dss-loris/main/Main.pdf

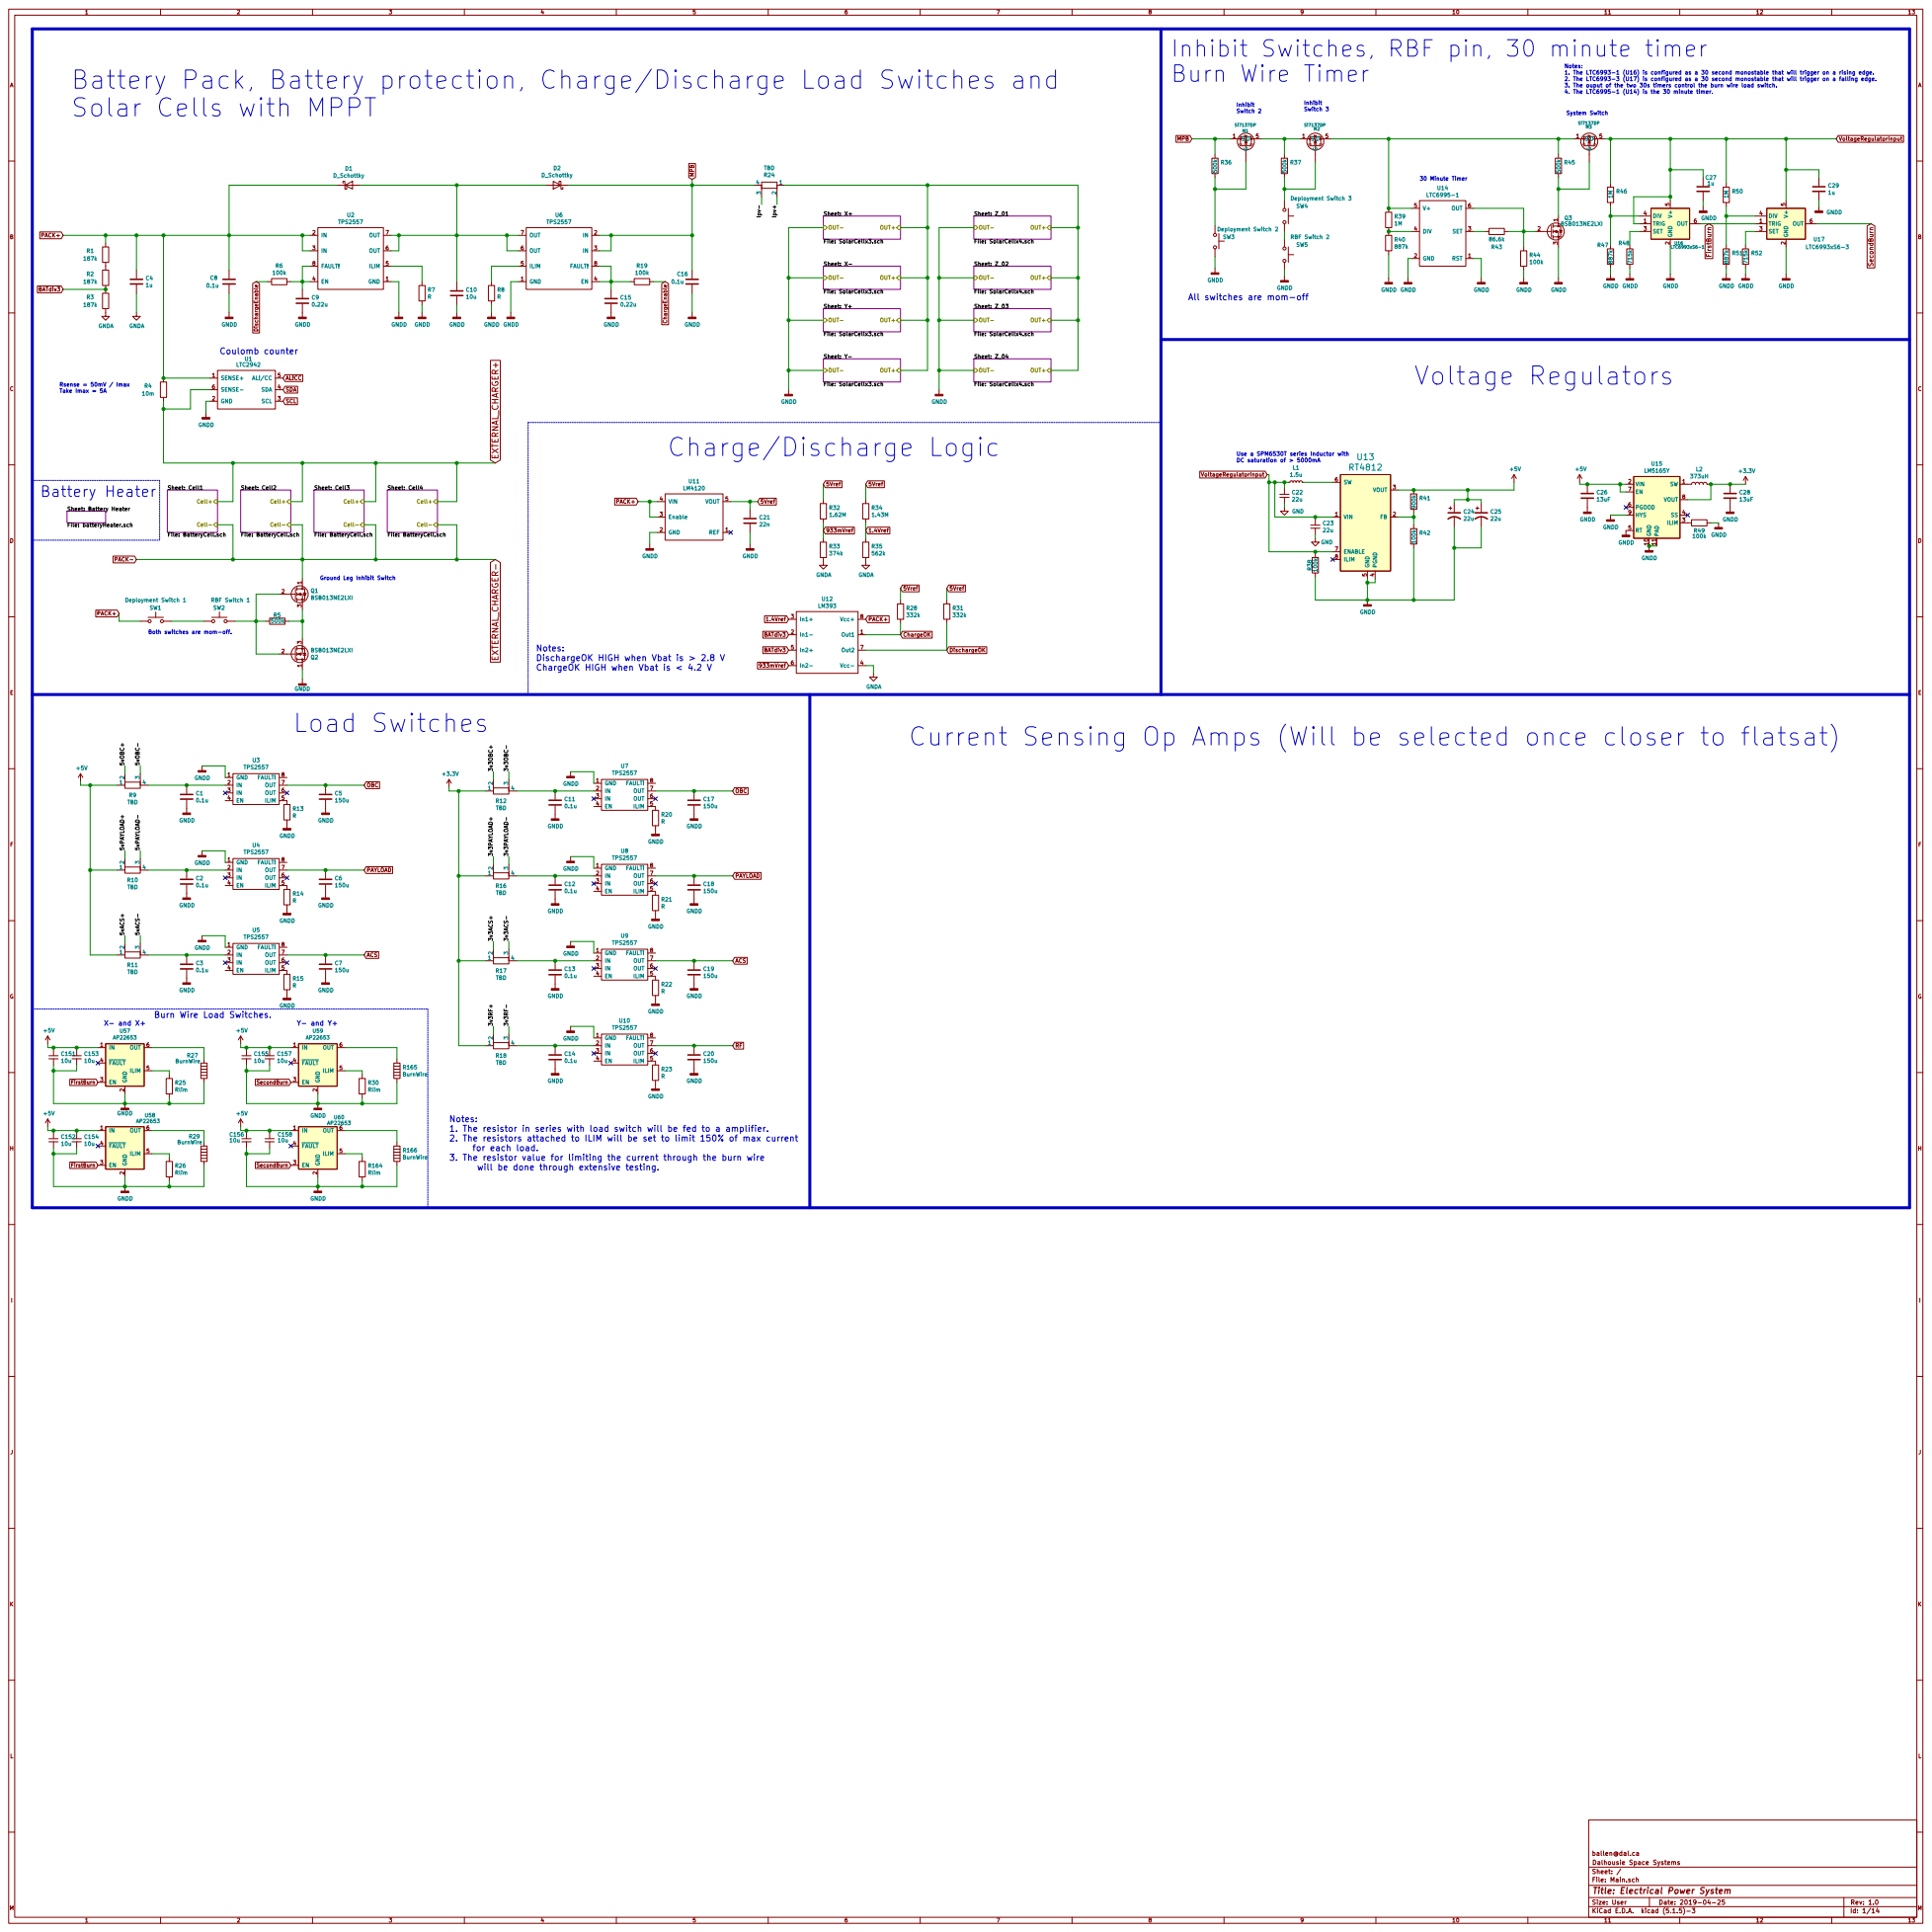
[picture p1: page 1]

Inhibit Switches, RBF pin, 30 minute timer
Burn Wire Timer

Solar Cells with MPPT

Notes: 1. The LTC6993-1 (U16) is configured as a 30 second monostable that will trigger on a rising edge.

2. The LTC6993-3 (U17) is configured as a 30 second monostable that will trigger on a falling edge.

Both switches are mom-off. Coulomb counter

GNDD
All switches are mom-off

Rsense = 50mV / Imax Take Imax = 5A

Notes:
DischargeOK HIGH when Vbat is > 2.8 V
ChargeOK HIGH when Vbat is < 4.2 V

Current Sensing Op Amps (Will be selected once closer to flatsat)

Burn Wire Load Switches.

1. The resistor in series with load switch will be fed to a amplifier.
2. The resistors attached to ILIM will be set to limit 150% of max current
for each load.
3. The resistor value for limiting the current through the burn wire
will be done through extensive testing.

ballen@dal.ca
File: Main.sch Sheet: / Dalhousie Space Systems

Id: 1/14 Title: Electrical Power System

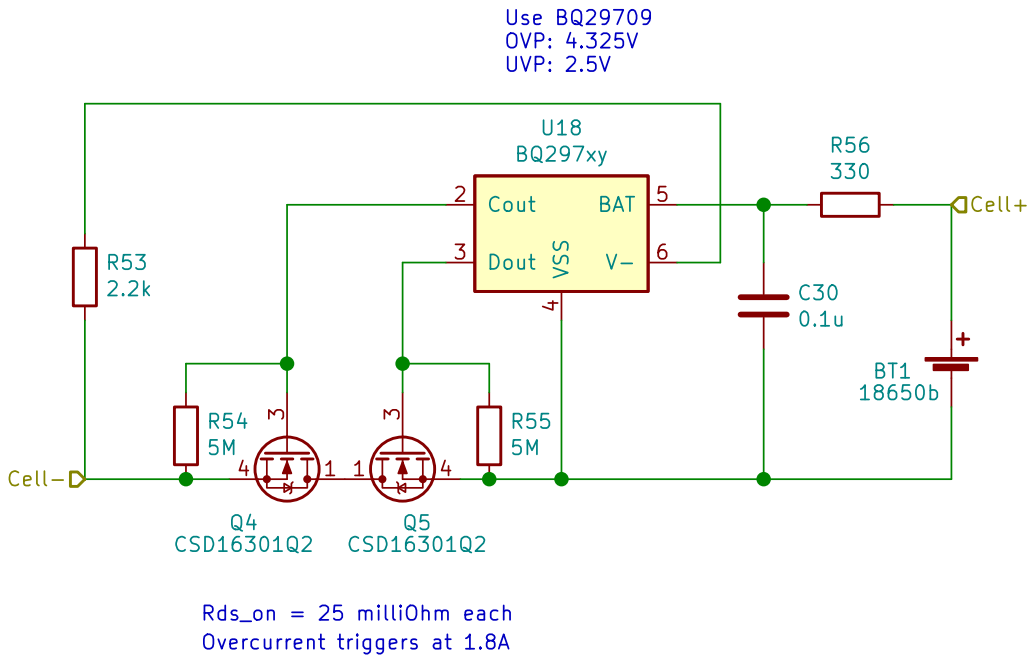
[picture p2: page 2]

File: BatteryCell.sch Sheet: /Cell1/
Id: 2/14 Title:

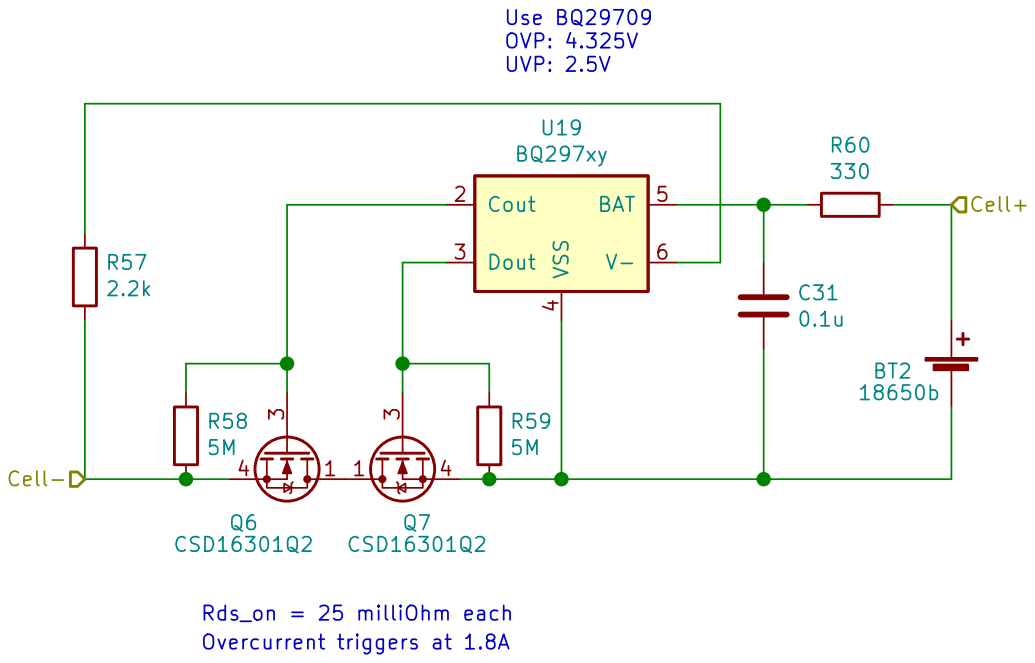
[picture p3: page 3]

File: BatteryCell.sch Sheet: /Cell2/
Id: 3/14 Title:

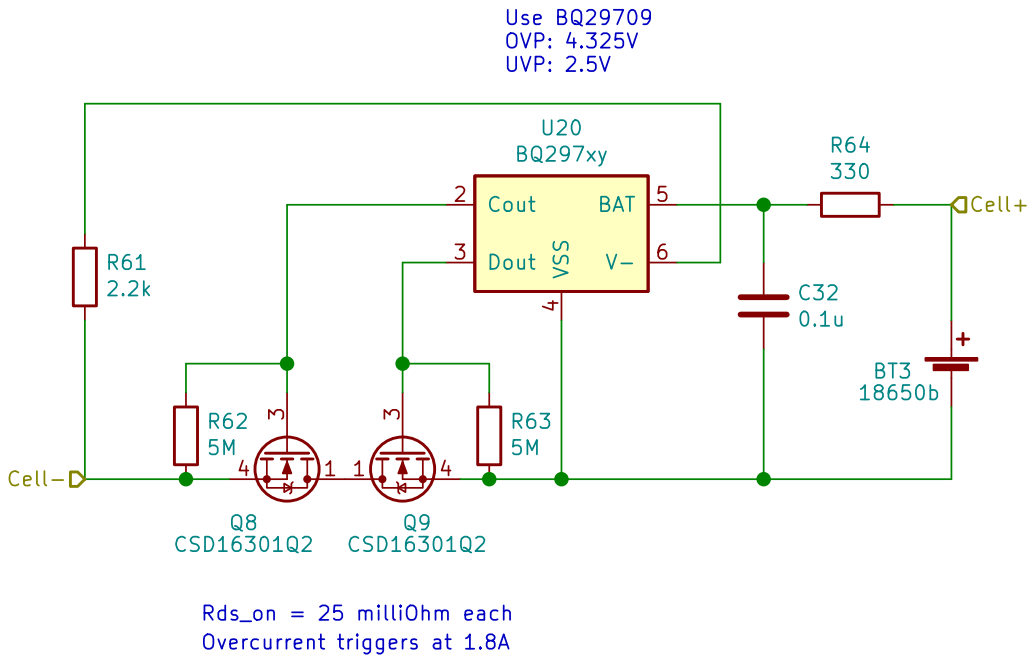
[picture p4: page 4]

File: BatteryCell.sch Sheet: /Cell3/
Id: 4/14 Title:

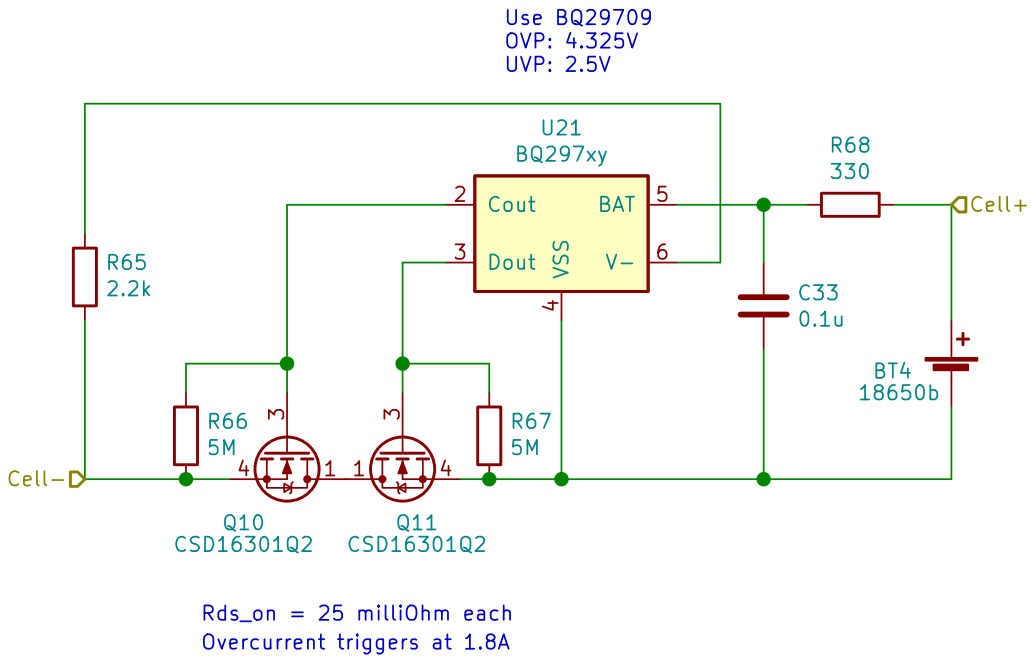
[picture p5: page 5]

File: BatteryCell.sch Sheet: /Cell4/
Id: 5/14 Title:

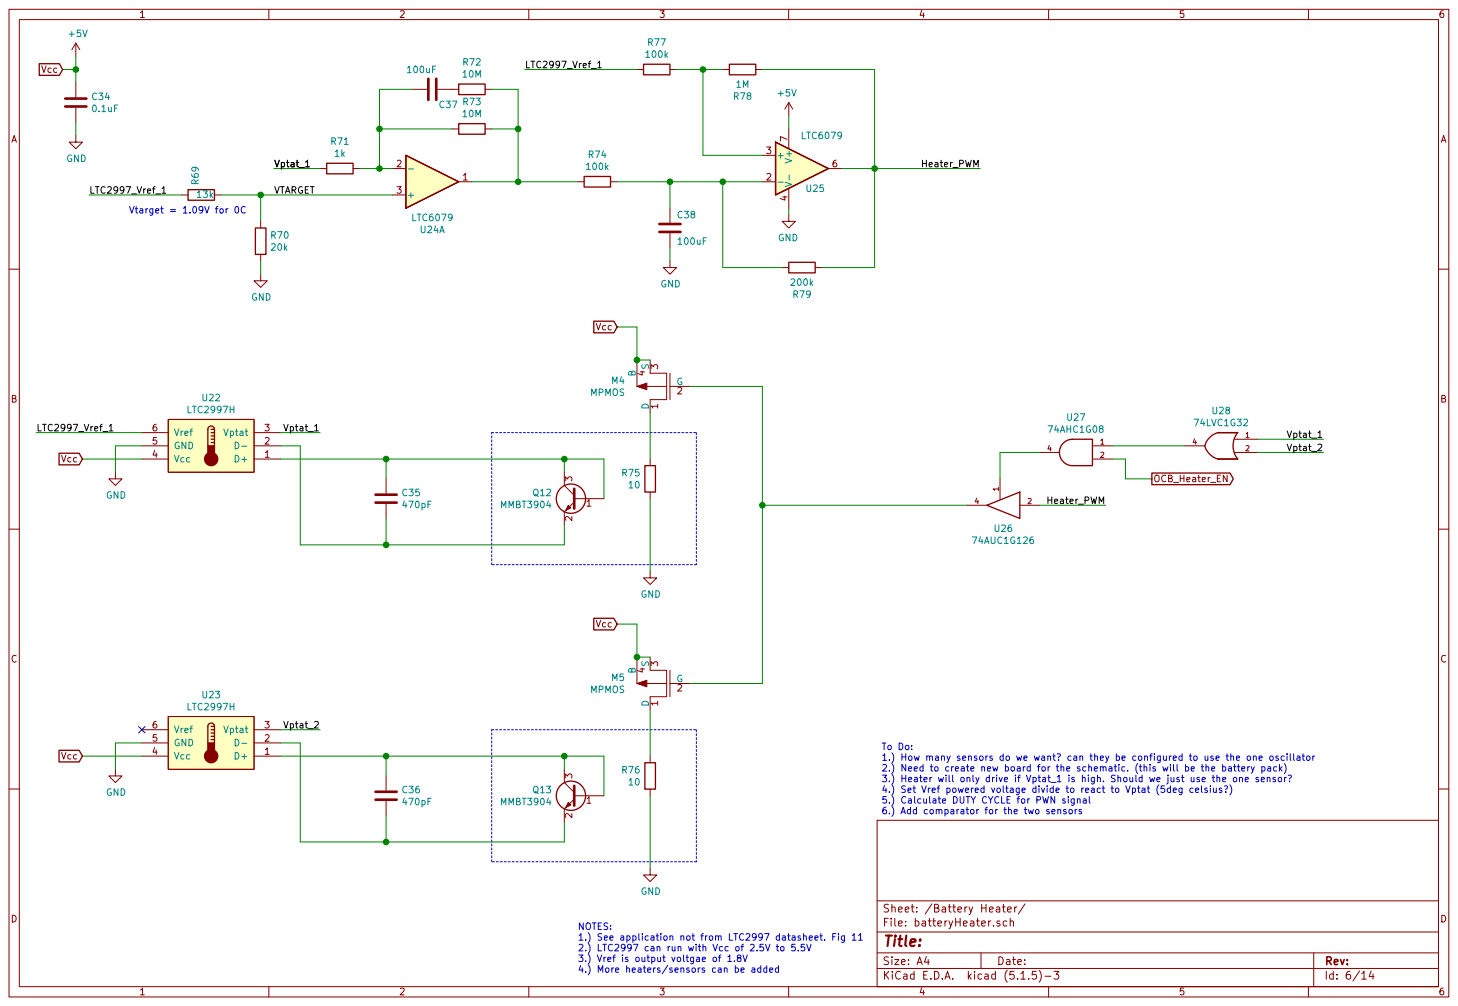
[picture p6: page 6]

Vptat_1 NOTES: 1.) See application not from LTC2997 datasheet. Fig 11

To Do: 1.) How many sensors do we want? can they be configured to use the one oscillator

2.) Need to create new board for the schematic. (this will be the battery pack)
3.) Heater will only drive if Vptat_1 is high. Should we just use the one sensor?
4.) Set Vref powered voltage divide to react to Vptat (5deg celsius?)
5.) Calculate DUTY CYCLE for PWN signal
6.) Add comparator for the two sensors

2.) LTC2997 can run with Vcc of 2.5V to 5.5V
3.) Vref is output voltgae of 1.8V
4.) More heaters/sensors can be added

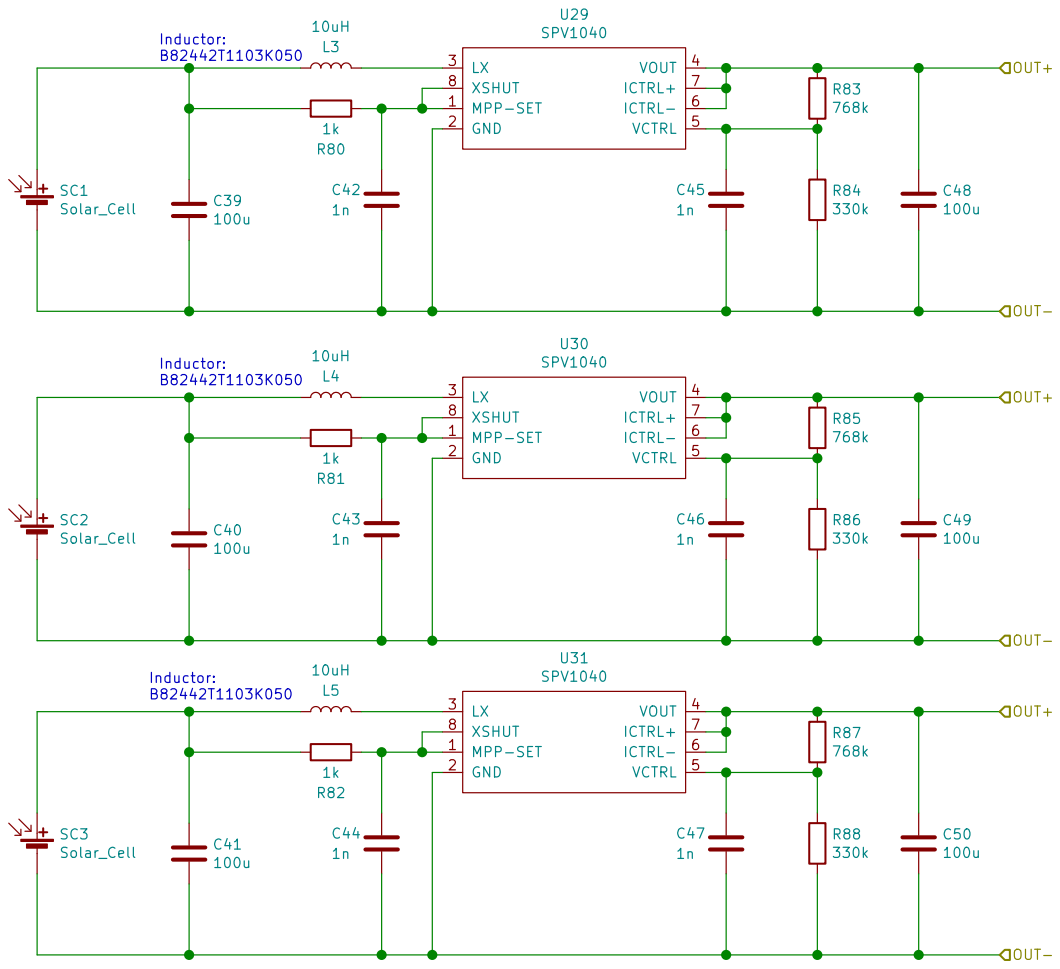
[picture p7: page 7]

OUT+ OUT+ OUT- OUT+ OUT-

Id: 7/14 Title: File: SolarCellx3.sch Sheet: /Y-/

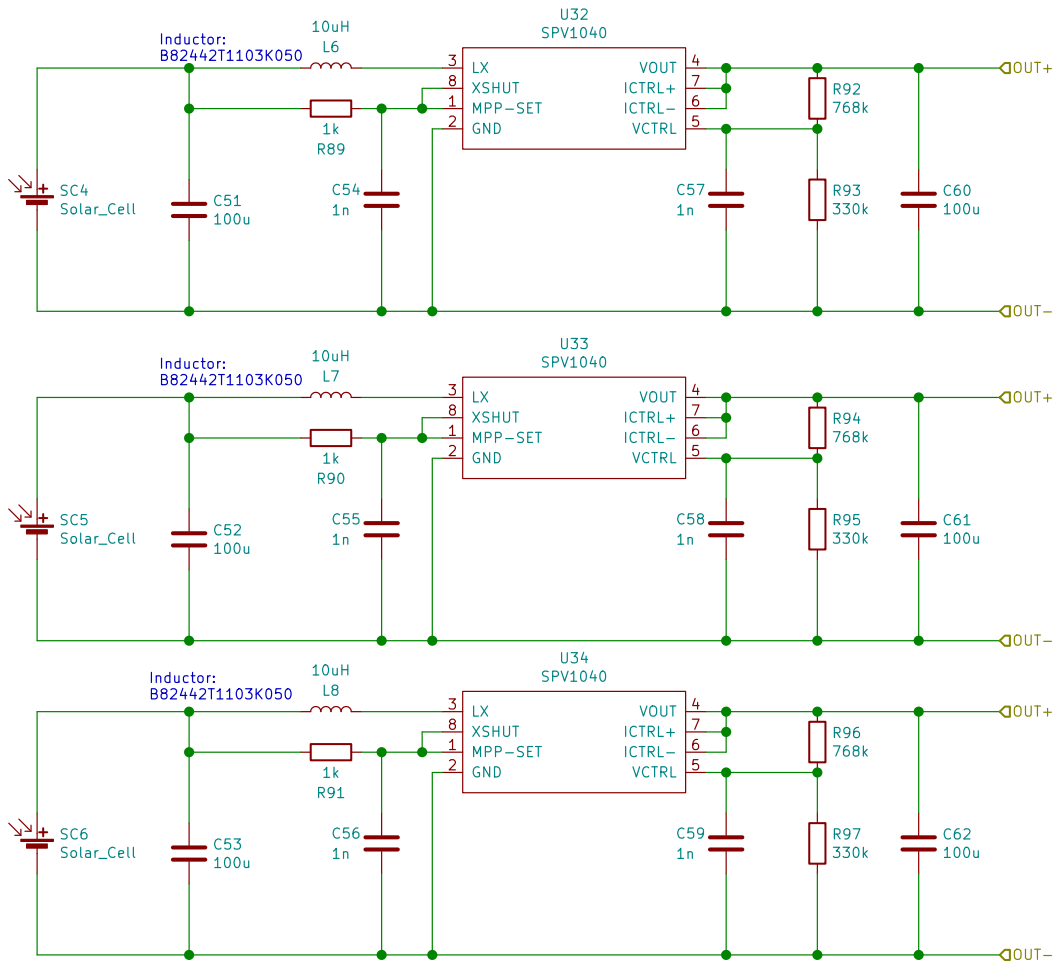
[picture p8: page 8]

OUT+ OUT+ OUT- OUT+ OUT-

Id: 8/14 Title: File: SolarCellx3.sch Sheet: /Y+/

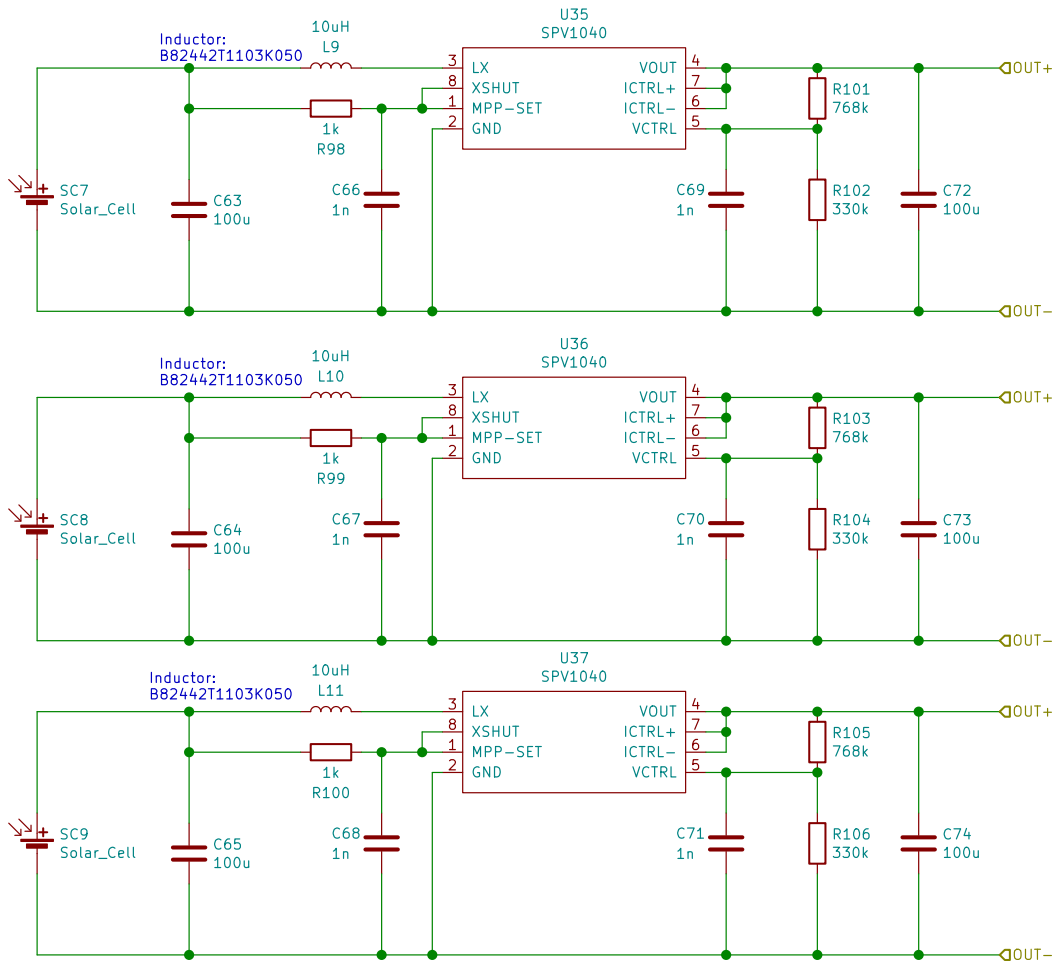
[picture p9: page 9]

OUT+ OUT+ OUT- OUT+ OUT-

Id: 9/14 Title: File: SolarCellx3.sch Sheet: /X-/

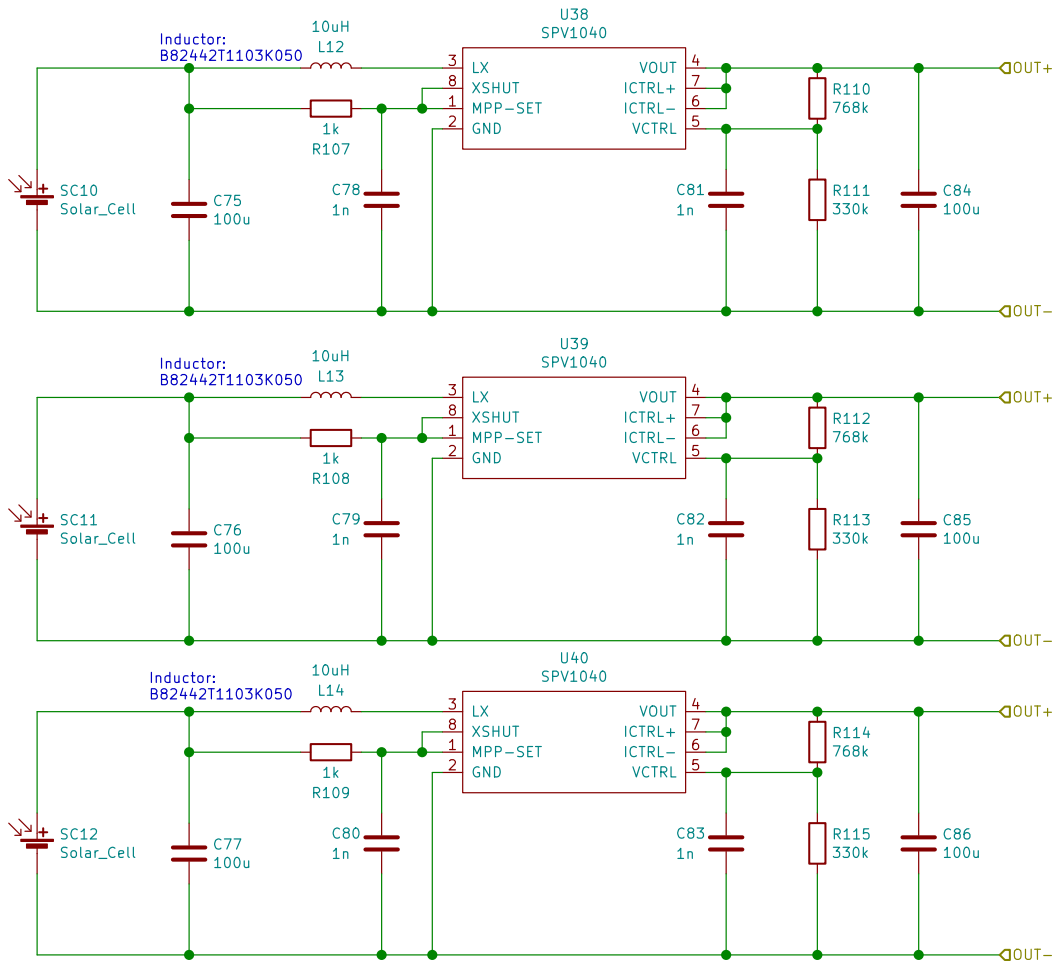
[picture p10: page 10]

OUT+ OUT+ OUT- OUT+ OUT-

Id: 10/14 Title: File: SolarCellx3.sch Sheet: /X+/

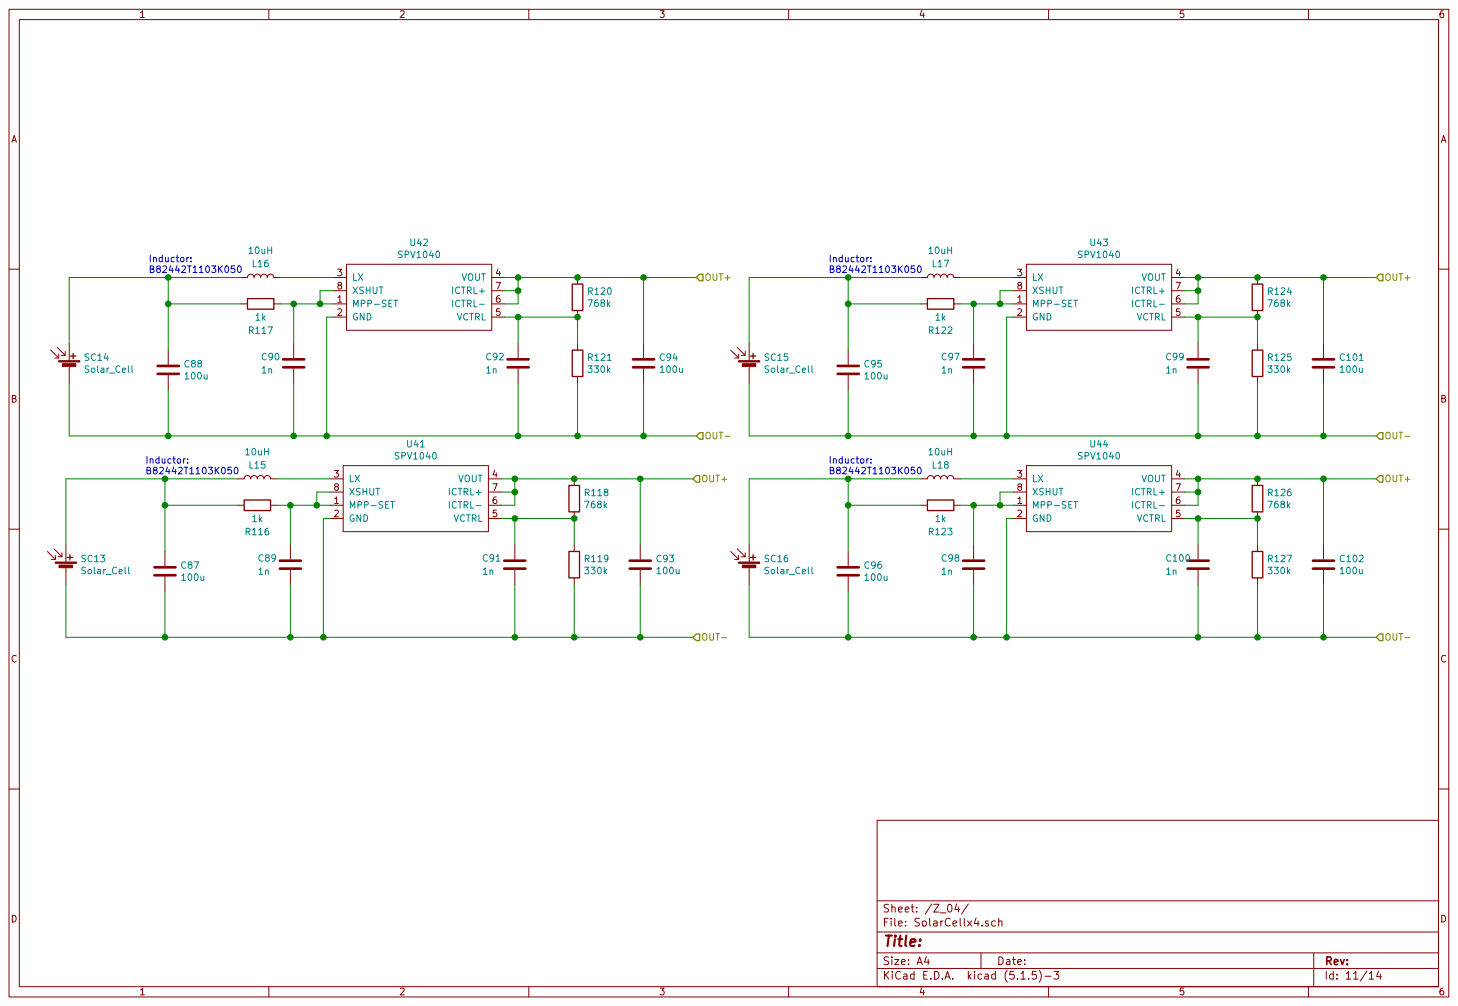
[picture p11: page 11]

Id: 11/14 Title: File: SolarCellx4.sch Sheet: /Z_04/ C87

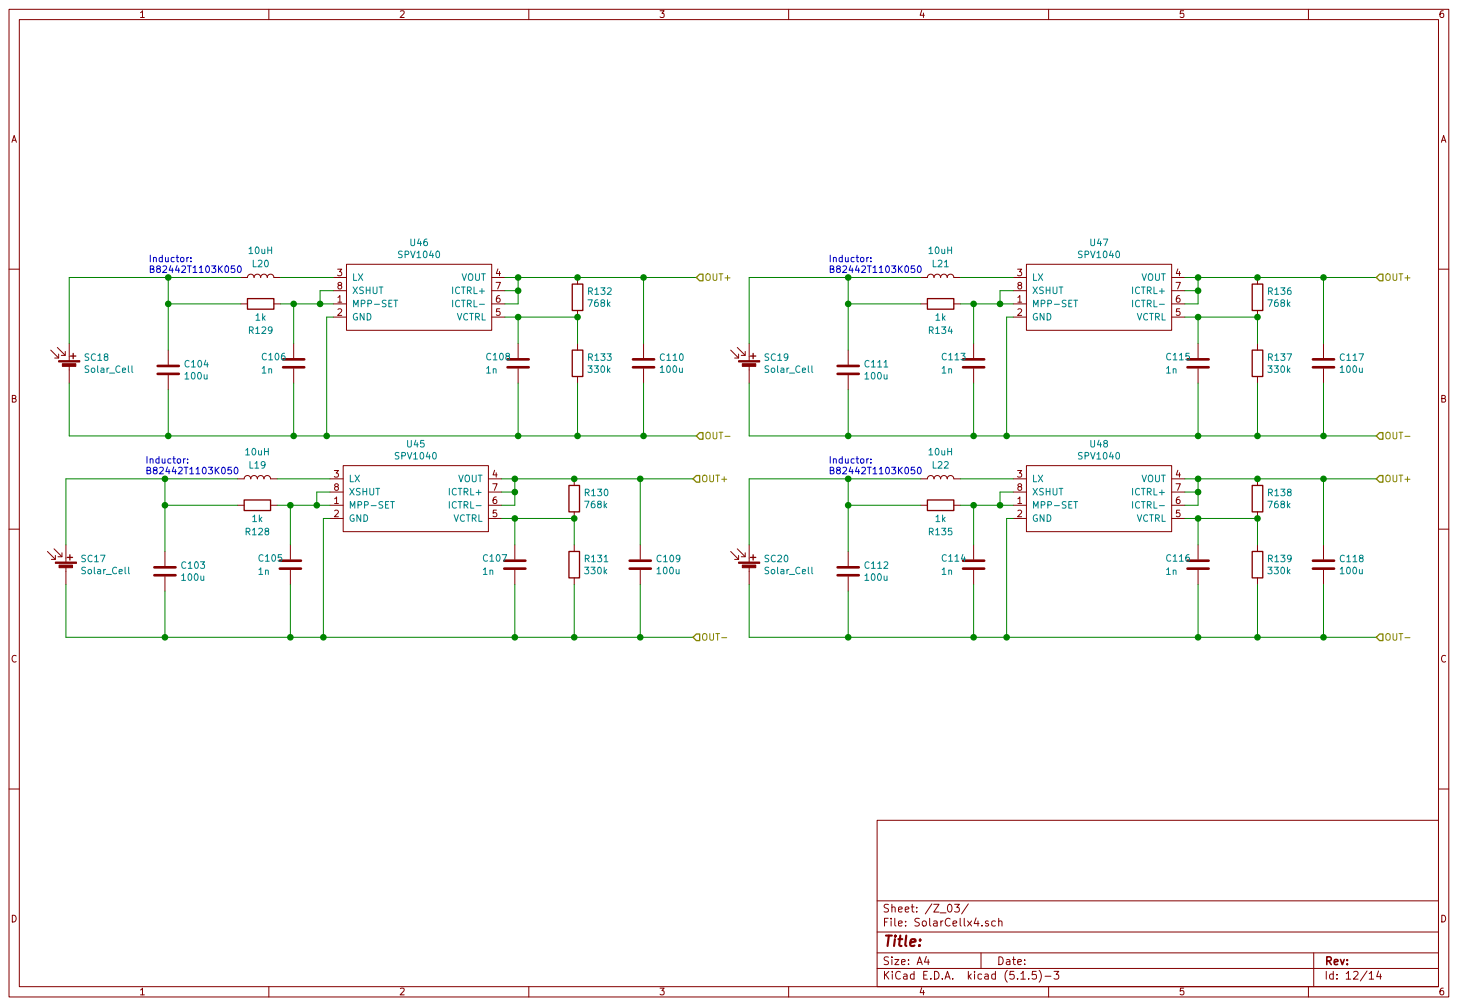
[picture p12: page 12]

Id: 12/14 Title: File: SolarCellx4.sch Sheet: /Z_03/ C103

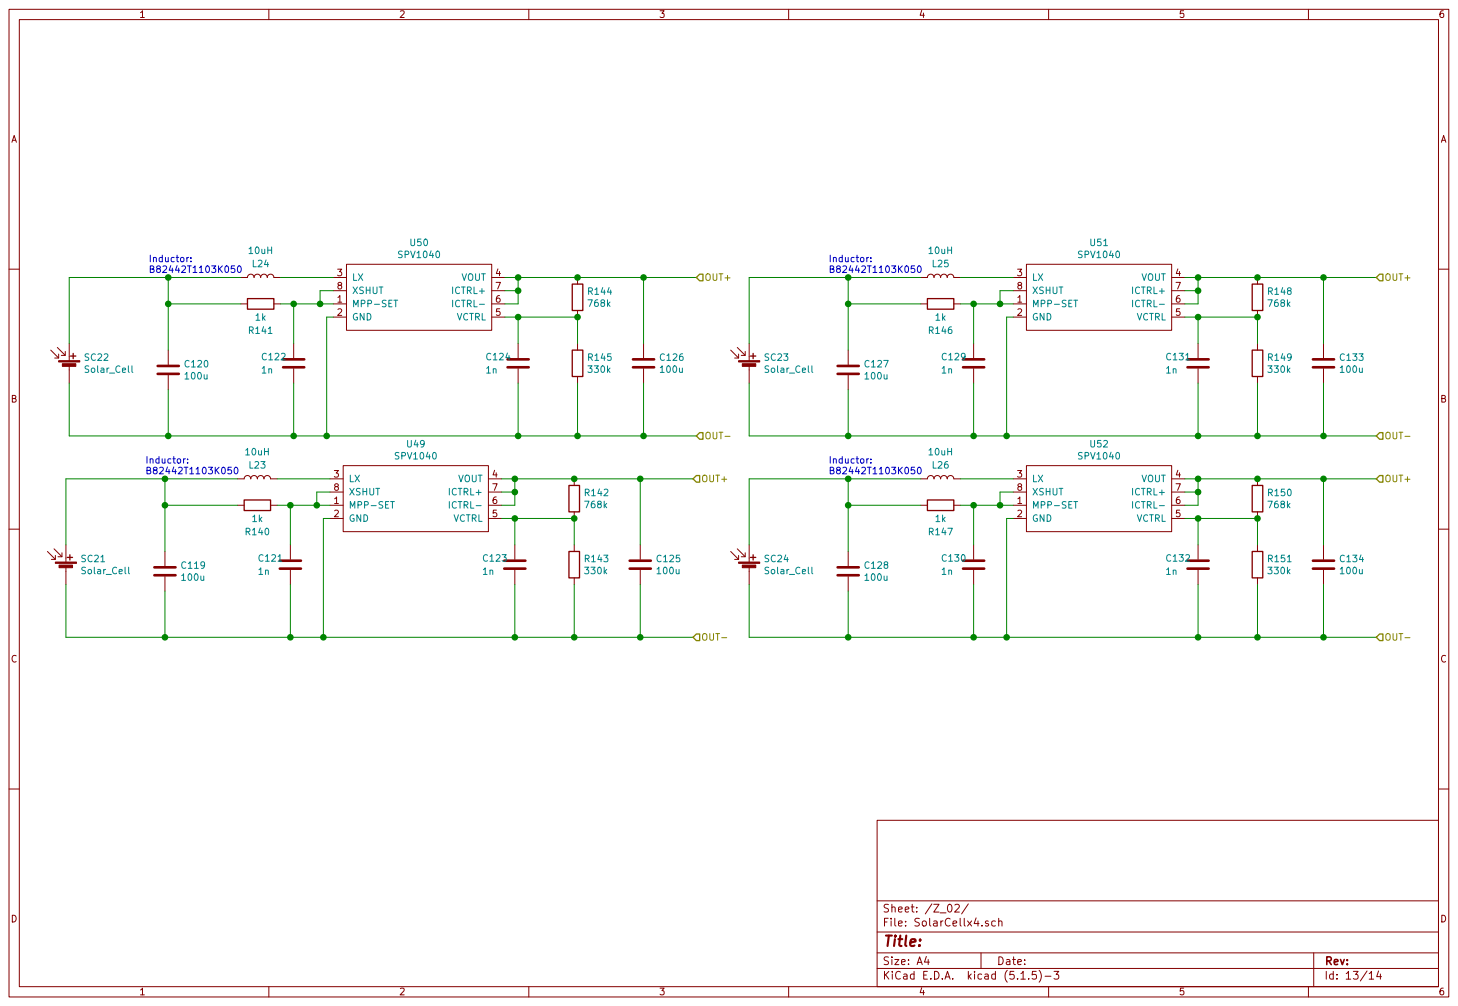
[picture p13: page 13]

Id: 13/14 Title: File: SolarCellx4.sch Sheet: /Z_02/ C119

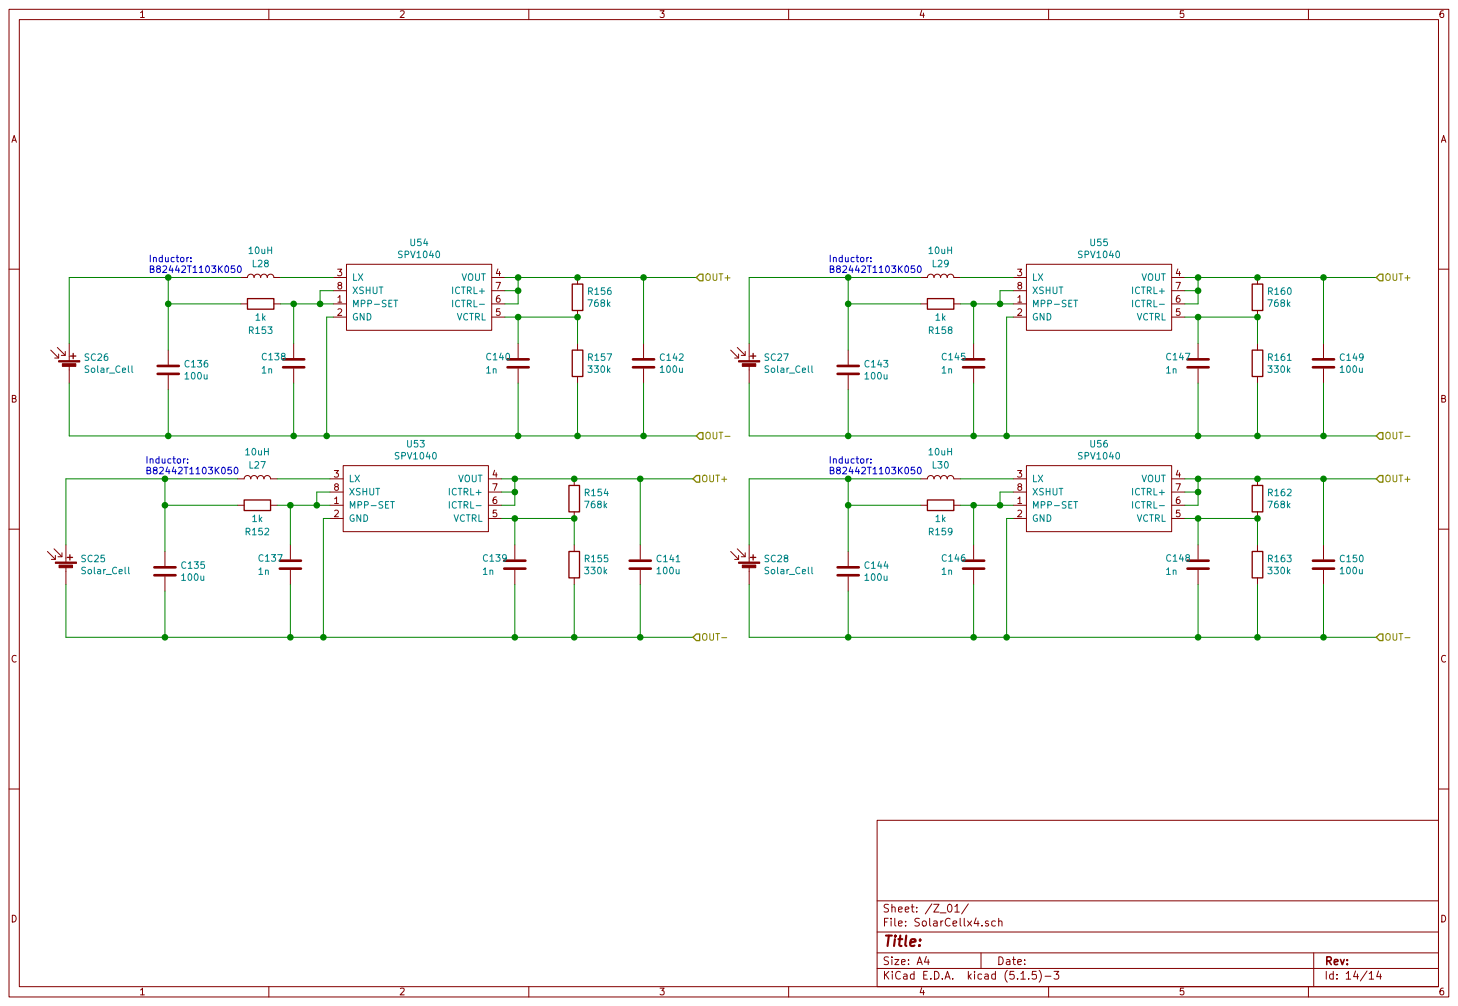
[picture p14: page 14]

Id: 14/14 Title: File: SolarCellx4.sch Sheet: /Z_01/ C135
