dss-loris/main/(commit log)

2019-06-24 Updated SPV1040 added two diodes
    [BCR.sch, BatteryCell.sch, SPV1040.sch]
2019-06-25 added ideal diode between BCR/BDR. Replaced load switch with ideal diode in inhibit switch circuit
    [3.3V_reg.sch, BCR.sch, BDR.sch, BatteryCell.sch, Current Sesnsing.sch, IdealDiode_4x.sch, Main.sch, SPV1040.sch]
2019-06-26 added LTC2942 coulomb counter to each cell
    [3.3V_reg.sch, BCR.sch, BDR.sch, BatteryCell.sch, Current Sesnsing.sch, IdealDiode_4x.sch, Low_pulser.sch, Main.kicad_pcb]
2019-06-26 Added coulomb counter for each cell
    [3.3V_reg.sch, BCR.sch, BDR.sch, BatteryCell.sch, Current Sesnsing.sch, IdealDiode_4x.sch, Low_pulser.sch, Main.kicad_pcb]
2019-06-26 Added coulomb counter for each cell with .sch included
    [Main.sch]
2019-07-04 Addded first portion of battery heater. Contains the temperature sensor and resistive heater. Need to add logic if it will be driven by OBC.
    [3.3V_reg.sch, BCR.sch, BDR.sch, BatteryCell.sch, Current Sesnsing.sch, Main.sch, SPV1040.sch, SolarRegulator.sch]
2020-01-30 Revisions to battery charge and discharge control. SPV1040 now regulates to 4.2V.
    [Main.sch, SPV1040.sch, SolarCellx3.sch, SolarCellx4.sch]
2020-01-31 Added control circuitry for charge and discharge.
    [Main.sch]
2020-02-01 Each deployment switch is now electrically coupled with a FET. The system switch is now a FET.
    [3.3V_reg.sch, BatteryCell.sch, Current Sesnsing.sch, Main.sch, SPV1040.sch, batteryHeater.sch]
2020-02-04 Logic added for circuit to be driven by OBC
    [batteryHeater.sch]
2020-02-04 added notes
    [batteryHeater.sch]
2020-02-04 added notes for battery heater circuit.
    [batteryHeater.sch]
2020-02-18 Fixed heater circuit to trigger at 0C. Removed TVS diodes
    [batteryHeater.sch]
2020-02-26 added sense resistor for solar cells
    [Current Sesnsing.sch, Main.sch, SPV1040.sch]
2020-05-12 added RBF pin
    [3.3V_reg.sch, BatteryCell.sch, Current Sesnsing.sch, Main.sch, SPV1040.sch, SolarCellx3.sch, SolarCellx4.sch, batteryHeater.sch]
2020-05-12 removed pdf schematic
2020-05-13 added external charging port
    [Main.sch]
2020-05-31 added 5v regulator :
    [Main.sch]
2020-06-02 added ground leg inhibit
    [BatteryCell.sch, Main.sch]
2020-06-04 changed mosfets in inhibit
    [BatteryCell.sch, Main.sch, SolarCellx3.sch, SolarCellx4.sch]
2020-06-12 added burn wire load switches
    [BatteryCell.sch, Main.sch, SolarCellx3.sch, SolarCellx4.sch, batteryHeater.sch]
